pkarcsi55/Demonstration-of-the-Photoelectric-Effect-Using-a-Neon-Glow-Lamp/Hardver/panel.png

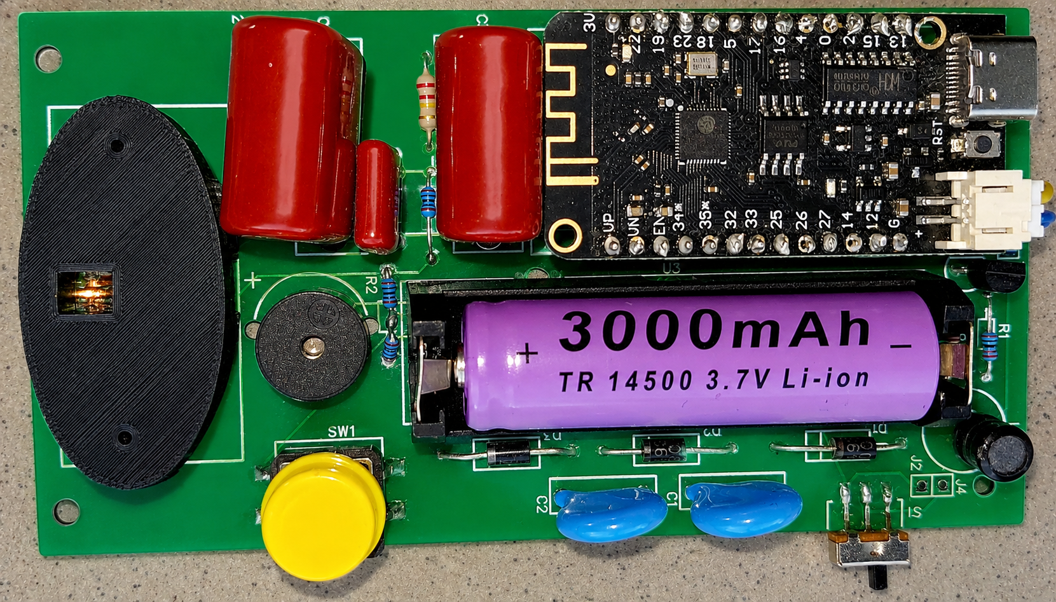
Hardver/panel.png
