pkarcsi55/Demonstration-of-the-Photoelectric-Effect-Using-a-Neon-Glow-Lamp/Hardver/Schematic_Glimm_2026-08-24.pdf

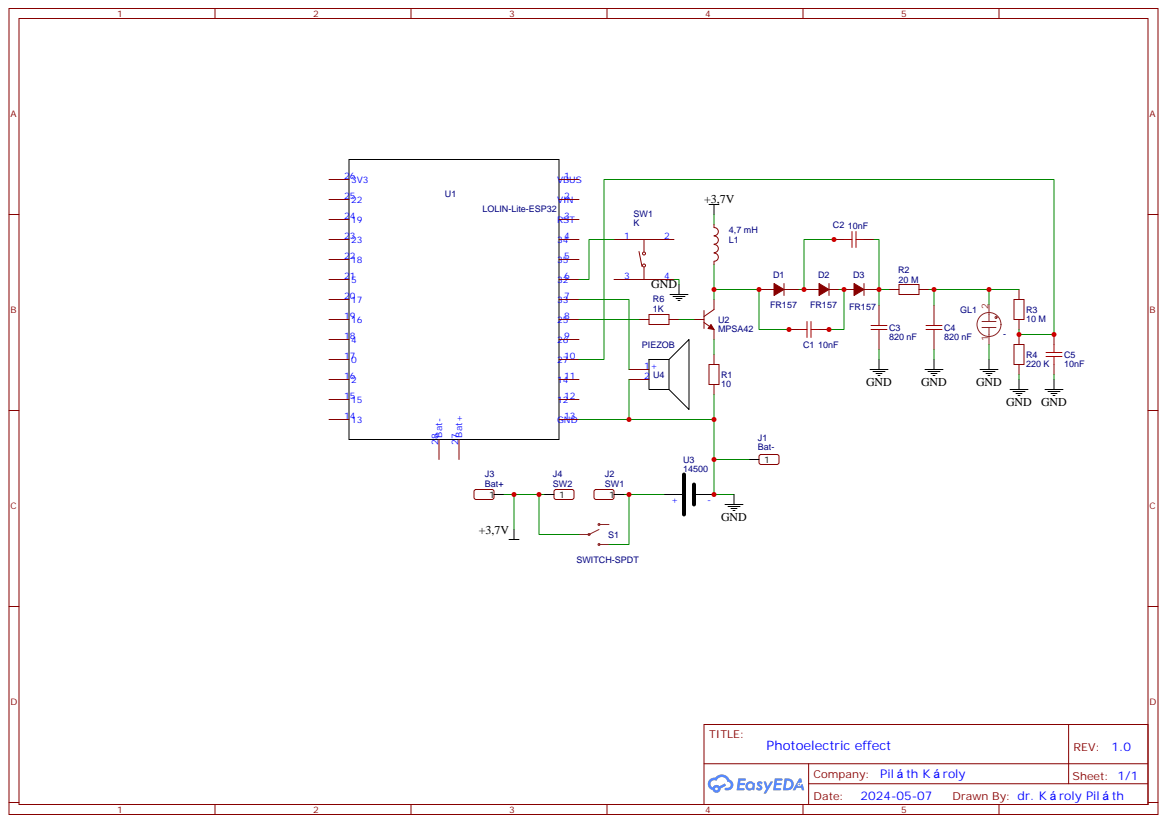
[picture p2: page 1]

Company: Pil th K roly

Drawn By: dr. K roly Pil th
