pkarcsi55/Demonstration-of-the-Photoelectric-Effect-Using-a-Neon-Glow-Lamp/(commit log)

2026-09-14 Add Glimmlámpás demo tool for studying photoelectric effect
    ESP32 firmware for controlling a high-voltage supply, sampling glow lamp voltage, detecting ignition peaks, and streaming measurement data over serial.
    Ha a „gyújtási csúcsok” helyett a fizikai jelenséghez még pontosabb angol kifejezést szeretnél, használhatod ezt is:
    ignition peaks
    striking peaks
    discharge ignition peaks
2026-09-14 Add Bill of Materials (BOM) for circuit components
    Added a Bill of Materials (BOM) for the circuit, detailing components, values, quantities, and notes for each part used in the design.
2026-09-14 Update neon glow lamp part number in BOM
    Updated the part number for the neon glow lamp to GLIMM1-OR (NEON-3).
2026-09-14 Update BOM with LCSC part for SPDT switch
    Added LCSC part information for SPDT switch.
2026-09-14 Fix link formatting for Gerber files in README
    Updated the link format for PCB manufacturing files.
2026-09-14 Update schematic reference in README.md
